amagsty/aDataFlow/README.md

串口查看器。README正在编写中。

[刷机教程（By Justin）](doc/manual/how_to_upload_firmware_BY_Justin.md)
