amagsty/aDataFlow/doc/pcb/BOM/BOM_Board_back_SCH_back_2024-01-13.xlsx

No. | Quantity | Device | Designator | Footprint | Value | Manufacturer Part | Manufacturer | Supplier Part | Supplier | LCSC Stock | LCSC Price
1 | 2 | CL05B104KO5NNNC | C1,C2 | C0402 | 100nF | CL05B104KO5NNNC | SAMSUNG(三星) | C1525 | LCSC | 93587 | 0.007113
2 | 1 | CL10A106KP8NNNC | C3 | C0603 | 10uF | CL10A106KP8NNNC | SAMSUNG(三星) | C19702 | LCSC | 52846 | 0.034305
3 | 36 | 19-213/Y2C-CQ2R2L/3T(CY) | LED1,LED2,LED3,LED4,LED5,LED6,LED7,LED8,LED9,LED10,LED11,LED12,LED13,LED14,LED15,LED16,LED17,LED18,LED19,LED20,LED21,LED22,LED23,LED24,LED25,LED26,LED27,LED28,LED29,LED30,LED31,LED32,LED33,LED34,LED35,LED36 | LED0603-RD-YELLOW |  | 19-213/Y2C-CQ2R2L/3T(CY) | EVERLIGHT(亿光) | C72038 | LCSC | 3903 | 0.129957
4 | 1 | AO3400A_C20917 | Q1 | SOT-23-3_L2.9-W1.6-P1.90-LS2.8-BR |  | AO3400A | AOS | C20917 | LCSC | 19822 | 0.453737
5 | 1 | 0402WGF1002TCE | R1 | R0402 | 10kΩ | 0402WGF1002TCE | UNI-ROYAL(厚声) | C25744 | LCSC | 73640 | 0.003026
6 | 2 | 0402WGF5103TCE | R2,R3 | R0402 | 510kΩ | 0402WGF5103TCE | UNI-ROYAL(厚声) | C11616 | LCSC | 9164 | 0.003056
7 | 9 | 4D03WGJ0102T5E | RN1,RN2,RN3,RN4,RN5,RN6,RN7,RN8,RN9 | RES-ARRAY-SMD_0603-8P-L3.2-W1.6-BL | 1kΩ | 4D03WGJ0102T5E | UNI-ROYAL(厚声) | C20197 | LCSC | 1393 | 0.038673
8 | 2 | 74HC595D,118 | U1,U2 | SOIC-16_L9.9-W3.9-P1.27-LS6.0-BL |  | 74HC595D,118 | Nexperia(安世) | C5947 | LCSC | 14827 | 0.745124
