amagsty/aDataFlow/doc/pcb/BOM/BOM_Board_front_2.51_SCH_front_1_2024-01-13.xlsx

No. | Quantity | Device | Designator | Footprint | Value | Manufacturer Part | Manufacturer | Supplier Part | Supplier | LCSC Stock | LCSC Price
1 | 5 | CL05A475MP5NRNC | C1,C2,C3,C4,C7 | C0402 | 4.7uF | CL05A475MP5NRNC | SAMSUNG(三星) | C23733 | LCSC | 19100 | 0.035571
2 | 3 | CL05B104KO5NNNC | C5,C6,C8 | C0402 | 100nF | CL05B104KO5NNNC | SAMSUNG(三星) | C1525 | LCSC | 93587 | 0.007113
3 | 2 | AFC01-S22FCA-00 | FPC1,FPC2 | FPC-SMD_P0.5-22P_FGS-XJ-H2.0 |  | AFC01-S22FCA-00 | JS(钜硕电子) | C262668 | LCSC | 2495 | 0.723461
4 | 2 | KT-0603R | LED1,LED2 | LED0603-RD |  | KT-0603R | KENTO | C2286 | LCSC | 21883 | 0.034095
5 | 1 | AO3400A_C20917 | Q1 | SOT-23-3_L2.9-W1.6-P1.90-LS2.8-BR |  | AO3400A | AOS | C20917 | LCSC | 19822 | 0.453737
6 | 2 | 0402WGF3300TCE | R1,R2 | R0402 | 330Ω | 0402WGF3300TCE | UNI-ROYAL(厚声) | C25104 | LCSC | 8341 | 0.003481
7 | 4 | 0402WGF1002TCE | R3,R4,R8,R10 | R0402 | 10kΩ | 0402WGF1002TCE | UNI-ROYAL(厚声) | C25744 | LCSC | 73640 | 0.003026
8 | 2 | 0402WGF1001TCE | R5,R6 | R0402 | 1kΩ | 0402WGF1001TCE | UNI-ROYAL(厚声) | C11702 | LCSC | 40589 | 0.003136
9 | 1 | 0603WAF100JT5E | R7 | R0603 | 10Ω | 0603WAF100JT5E | UNI-ROYAL(厚声) | C22859 | LCSC | 28222 | 0.005768
10 | 1 | GT36516 | R9 | RES-SMD_L3.6-W2.4 |  | GT36516 | JCHL(晶创和立) | C2904880 | LCSC | 282 | 1.0097
11 | 2 | TS-1187A-B-A-B | SW1,SW2 | SW-SMD_4P-L5.1-W5.1-P3.70-LS6.5-TL-2 |  | TS-1187A-B-A-B | XKB Connectivity(中国星坤) | C318884 | LCSC | 7282 | 0.09702
12 | 22 | XL-1010RGBC-WS2812B | U1,U2,U3,U4,U5,U6,U7,U8,U9,U10,U11,U12,U13,U14,U15,U16,U17,U18,U19,U20,U21,U22 | LED-SMD_4P-L1.0-W1.0-TL_XL-1010RGBC-WS2812B |  | XL-1010RGBC-WS2812B | XINGLIGHT(成兴光) | C5349953 | LCSC | 1583 | 0.331514
