amagsty/aDataFlow/doc/pcb/BOM/BOM_Board_prog_Schematic1_2024-01-13.xlsx

No. | Quantity | Device | Designator | Footprint | Value | Manufacturer Part | Manufacturer | Supplier Part | Supplier | LCSC Stock | LCSC Price
1 | 5 | YTC1P-2510-01 | CN1,CN2,CN3,CN4,CN5 | SMD-1_BD2.0-H10.0 |  | YTC1P-2510-01 | YIYUAN(怡远) | C5221288 | LCSC | 849 | 0.569205
2 | 1 | PZ254R-11-05P | H1 | HDR-TH_5P-P2.54-H-M-W10.4 |  | PZ254R-11-05P | XFCN(兴飞) | C492413 | LCSC | 57 | 0.19305
