amagsty/aDataFlow/doc/shoppinglist/购买链接.pdf

屏幕

【因屏线尺寸情况，暂无替代屏幕】

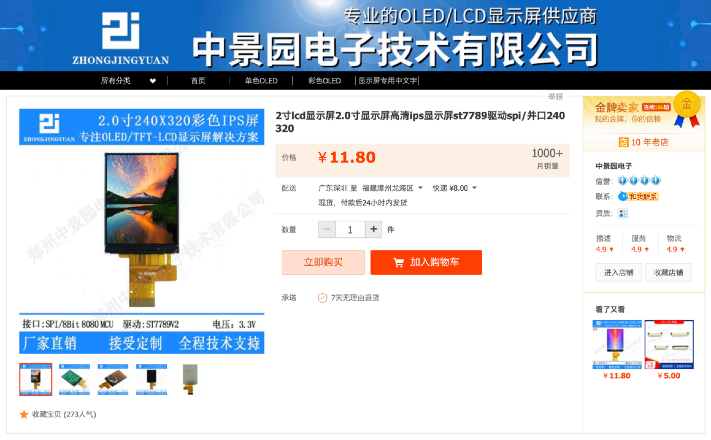
[picture p3: figure]

2寸lcd显示屏2.0寸显示屏高清ips显示屏st7789驱动spi/并口240320 https://item.taobao.com/item.htm?id=653306169973

### 白色铝箔胶带

【关键参数：白色铝箔胶带，厚度0.05左右，宽度1CM左右】

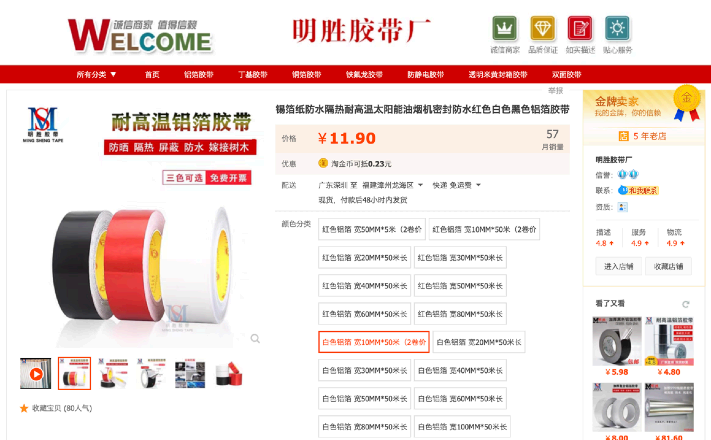
[picture p4: figure]

锡箔纸防水隔热耐高温太阳能油烟机密封防水红色白色黑色铝箔胶带 颜色分类：白色铝箔 宽10MM*50米（2卷价）
https://item.taobao.com/item.htm?id=679579753042

### 螺丝：M2

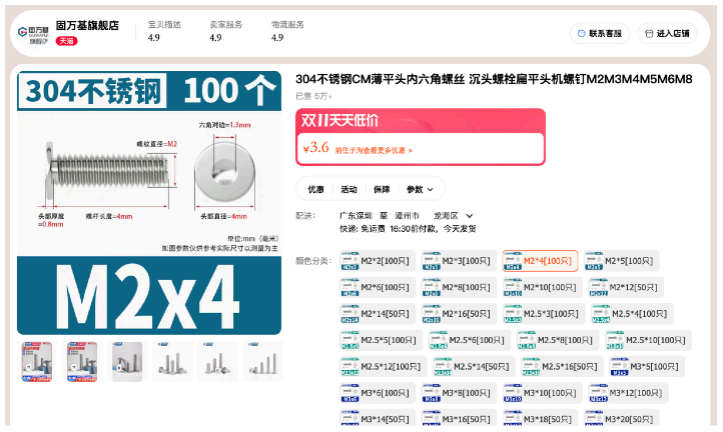
[picture p5: figure]

沉头304不锈钢内六角螺丝
颜色分类：M2*4[100只]
颜色分类：M2*6[100只]
https://item.taobao.com/item.htm?id=643512747051

### 螺丝：M1.6

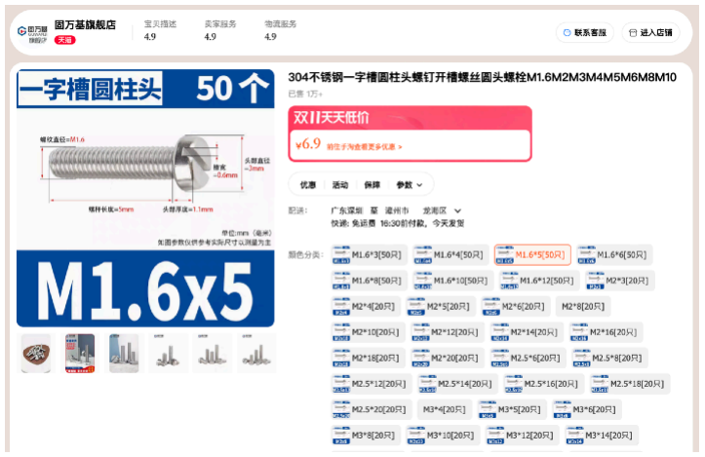
[picture p6: figure]

304不锈钢一字槽圆柱头螺钉开槽螺丝圆头螺栓M1.6M2M3M4M5M6M8M10 颜色分类：M1.6*5[50只]
https://item.taobao.com/item.htm?id=649361914483

### 螺丝弹垫：M2

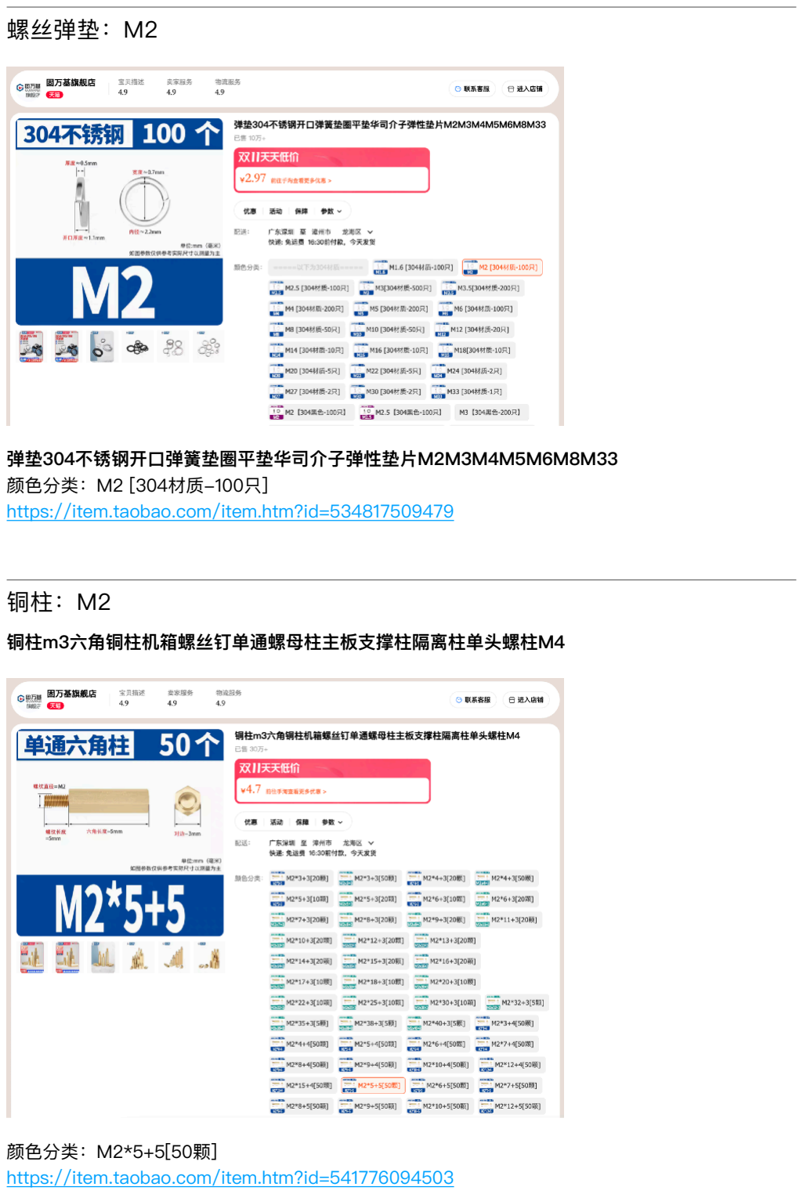
[picture p7: page 3]

弹垫304不锈钢开口弹簧垫圈平垫华司介子弹性垫片M2M3M4M5M6M8M33 颜色分类：M2 [304材质-100只]
https://item.taobao.com/item.htm?id=534817509479

### 铜柱：M2

铜柱m3六角铜柱机箱螺丝钉单通螺母柱主板支撑柱隔离柱单头螺柱M4

颜色分类：M2*5+5[50颗]
https://item.taobao.com/item.htm?id=541776094503

### 亚克力面板弧面抛光块

【关键参数：1000目及1万目】

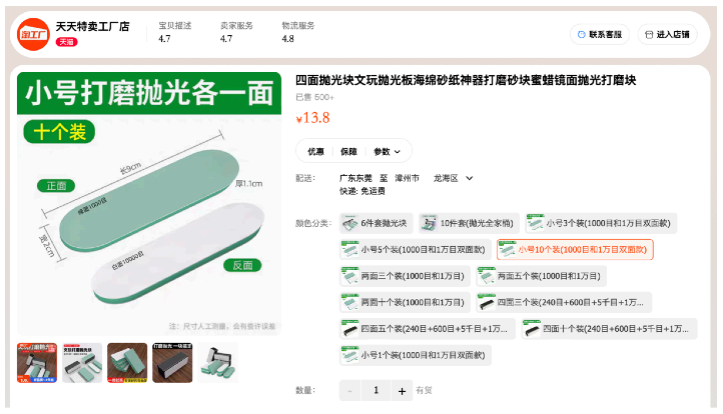
[picture p8: figure]

四面抛光块文玩抛光板海绵砂纸神器打磨砂块蜜蜡镜面抛光打磨块 颜色分类：小号10个装(1000目和1万目双面款)
https://item.taobao.com/item.htm?id=722835001711

脚垫

【关键参数：25MM长，4MM宽】

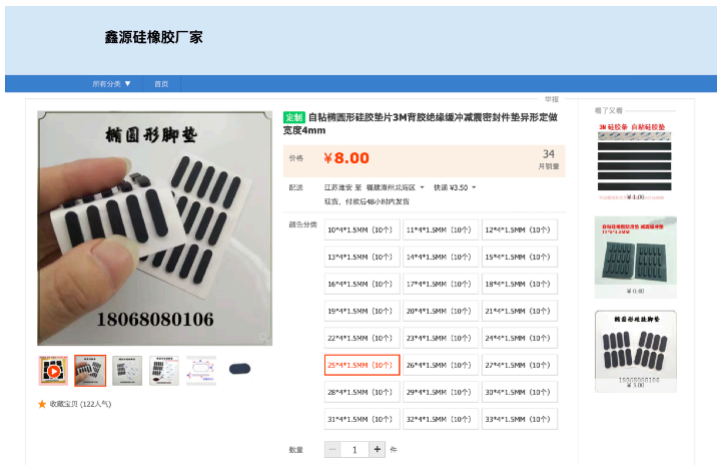
[picture p9: figure]

自粘椭圆形硅胶垫片3M背胶绝缘缓冲减震密封件垫异形定做宽度4mm 颜色分类：25*4*1.5MM（10个）
https://item.taobao.com/item.htm?id=691930664475

### 导光柱

【关键参数：直径1.5MM，长度10MM】

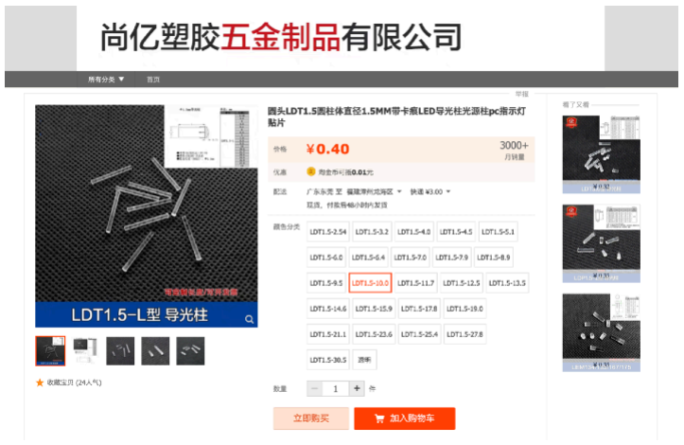
[picture p10: figure]

圆头LDT1.5圆柱体直径1.5MM带卡痕LED导光柱光源柱pc指示灯贴片 颜色分类：LDT1.5-10.0
https://item.taobao.com/item.htm?id=628488136793

电池

【关键参数：452540/502540，厚度≦5MM】

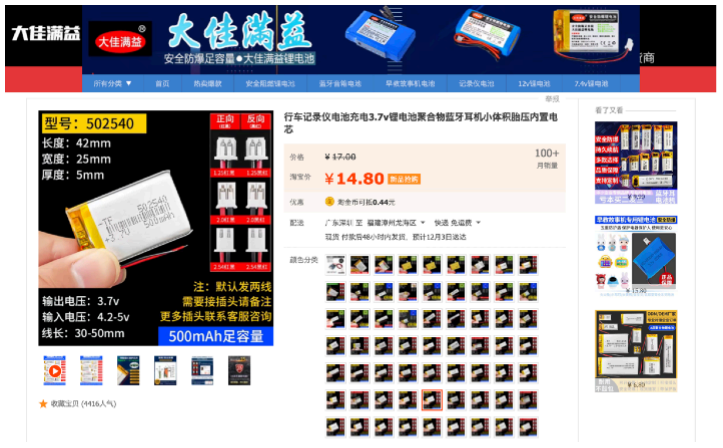
[picture p11: figure]

行车记录仪电池充电3.7v锂电池聚合物蓝牙耳机小体积胎压内置电芯 颜色分类：深卡其布色[502540/500毫安]
https://item.taobao.com/item.htm?id=677735645908
