amagsty/aDataFlow/doc/pcb/BOM/BOM_Board_conn_2.51_SCH_conn_2.51_2024-01-13.xlsx

No. | Quantity | Device | Designator | Footprint | Value | Manufacturer Part | Manufacturer | Supplier Part | Supplier | LCSC Stock | LCSC Price
1 | 2 | PJ-342_C668606 | CN1,CN2 | AUDIO-SMD_PJ-342 |  | PJ-342 | SHOU HAN(首韩) | C668606 | LCSC | 6420 | 1.1074
2 | 1 | X0509FRS-20AS-LPV01 | CN3 | CONN-SMD_20P-P0.50_XKB_X0509FRS-20ADS-LPV01 |  | X0509FRS-20AS-LPV01 | XKB Connectivity(中国星坤) | C2925324 | LCSC | 500 | 3.5
3 | 9 | LESD5D5.0CT1G | D1,D2,D3,D4,D5,D6,D7,D8,D9 | SOD-523_L1.2-W0.8-LS1.6-BI |  | LESD5D5.0CT1G | LRC(乐山无线电) | C383211 | LCSC | 1463 | 0.108493
4 | 1 | 0402WGF1002TCE | R1 | R0402 | 10kΩ | 0402WGF1002TCE | UNI-ROYAL(厚声) | C25744 | LCSC | 73640 | 0.003026
5 | 7 | 0402WGF0000TCE | R2,R3,R5,R7,R8,R9,R10 | R0402 | 0Ω | 0402WGF0000TCE | UNI-ROYAL(厚声) | C17168 | LCSC | 36394 | 0.003049
6 | 2 | 0402WGF5100TCE | R4,R6 | R0402 | 510Ω | 0402WGF5100TCE | UNI-ROYAL(厚声) | C25123 | LCSC | 4102 | 0.003066
7 | 1 | K3-1280S-K1 | SW1 | SW-SMD_K3-1280S-K1 |  | K3-1280S-K1 | 韩国韩荣 | C128953 | LCSC | 101 | 1.0343
8 | 2 | SMTWE2020MTJ | U1,U2 | SMD_BD4.4-L4.4-D2.8 |  | SMTWE2020MTJ | Sinhoo(雄和远景) | C2928177 | LCSC | 536 | 0.358189
