amagsty/aDataFlow/doc/pcb/BOM/BOM_Board_main_2.51_SCH_main_2.51_2024-01-13.xlsx

No. | Quantity | Device | Designator | Footprint | Value | Manufacturer Part | Manufacturer | Supplier Part | Supplier | LCSC Stock | LCSC Price
1 | 3 | CL10A106KP8NNNC | C1,C2,C6 | C0603 | 10uF | CL10A106KP8NNNC | SAMSUNG(三星) | C19702 | LCSC | 52846 | 0.034305
2 | 12 | CL05B104KO5NNNC | C3,C7,C9,C10,C11,C13,C15,C16,C17,C18,C19,C20 | C0402 | 100nF | CL05B104KO5NNNC | SAMSUNG(三星) | C1525 | LCSC | 93587 | 0.007113
3 | 7 | CL05A105KA5NQNC | C4,C5,C14,C28,C29,C30,C31 | C0402 | 1uF | CL05A105KA5NQNC | SAMSUNG(三星) | C52923 | LCSC | 19837 | 0.023666
4 | 5 | CL05A475MP5NRNC | C8,C12,C24,C26,C27 | C0402 | 4.7uF | CL05A475MP5NRNC | SAMSUNG(三星) | C23733 | LCSC | 19100 | 0.035571
5 | 3 | CL21A476MQYNNNE | C21,C22,C23 | C0805 | 47uF | CL21A476MQYNNNE | SAMSUNG(三星) | C16780 | LCSC | 9671 | 0.182771
6 | 1 | 0402CG220J500NT | C25 | C0402 | 22pF | 0402CG220J500NT | FH(风华) | C1555 | LCSC | 3777 | 0.005581
7 | 1 | TF-01A_C91145 | CARD1 | TF-SMD_TF-01A |  | TF-01A | 韩国韩荣 | C91145 | LCSC | 5318 | 1.097
8 | 1 | X0509WVS-20AS-LPV01 | CN1 | CONN-SMD_20P-P0.50_XKB_X0509WVS-20ADS-LPV01 |  | X0509WVS-20AS-LPV01 | XKB Connectivity(中国星坤) | C2925323 | LCSC | 1318 | 3.58
9 | 3 | 1N5819WS_C191023 | D1,D2,D7 | SOD-323_L1.8-W1.3-LS2.5-RD |  | 1N5819WS | Hottech(合科泰) | C191023 | LCSC | 7193 | 0.077033
10 | 3 | LESD5D5.0CT1G | D3,D4,D5 | SOD-523_L1.2-W0.8-LS1.6-BI |  | LESD5D5.0CT1G | LRC(乐山无线电) | C383211 | LCSC | 1463 | 0.108493
11 | 1 | B5819W SL | D6 | SOD-123_L2.7-W1.6-LS3.7-RD-1 |  | B5819W SL | CJ(江苏长电/长晶) | C8598 | LCSC | 18493 | 0.171405
12 | 1 | AFC01-S22FCA-00 | FPC1 | FPC-SMD_P0.5-22P_FGS-XJ-H2.0 |  | AFC01-S22FCA-00 | JS(钜硕电子) | C262668 | LCSC | 2495 | 0.723461
13 | 1 | SWPA3015S100MT | L1 | IND-SMD_L3.0-W3.0_SWPA3010S | 10uH | SWPA3015S100MT | Sunlord(顺络) | C45403 | LCSC | 1293 | 0.250713
14 | 2 | ME6211C33M5G-N | LDO1,LDO2 | SOT-23-5_L3.0-W1.7-P0.95-LS2.8-BL |  | ME6211C33M5G-N | MICRONE(南京微盟) | C82942 | LCSC | 7690 | 0.284668
15 | 1 | KT-0603R | LED1 | LED0603-RD |  | KT-0603R | KENTO | C2286 | LCSC | 21883 | 0.034095
16 | 7 | AO3401A_C15127 | Q1,Q2,Q7,Q8,Q9,Q10,Q11 | SOT-23_L2.9-W1.3-P1.90-LS2.4-BR |  | AO3401A | AOS | C15127 | LCSC | 14112 | 0.394475
17 | 5 | AO3400A_C20917 | Q3,Q4,Q12,Q13,Q14 | SOT-23-3_L2.9-W1.6-P1.90-LS2.8-BR |  | AO3400A | AOS | C20917 | LCSC | 19822 | 0.453737
18 | 2 | SS8050_C2150 | Q5,Q6 | SOT-23-3_L2.9-W1.3-P1.90-LS2.4-BR |  | SS8050 | CJ(江苏长电/长晶) | C2150 | LCSC | 15170 | 0.091187
19 | 13 | 0402WGF1002TCE | R1,R3,R6,R10,R12,R13,R15,R17,R20,R21,R23,R27,R28 | R0402 | 10kΩ | 0402WGF1002TCE | UNI-ROYAL(厚声) | C25744 | LCSC | 73640 | 0.003026
20 | 2 | 0402WGF5100TCE | R2,R5 | R0402 | 510Ω | 0402WGF5100TCE | UNI-ROYAL(厚声) | C25123 | LCSC | 4102 | 0.003066
21 | 3 | 0402WGF1003TCE | R4,R8,R26 | R0402 | 100kΩ | 0402WGF1003TCE | UNI-ROYAL(厚声) | C25741 | LCSC | 27511 | 0.003055
22 | 3 | 0402WGF5101TCE | R7,R14,R16 | R0402 | 5.1kΩ | 0402WGF5101TCE | UNI-ROYAL(厚声) | C25905 | LCSC | 14863 | 0.003109
23 | 2 | 0402WGF1001TCE | R9,R24 | R0402 | 1kΩ | 0402WGF1001TCE | UNI-ROYAL(厚声) | C11702 | LCSC | 40589 | 0.003136
24 | 1 | 0402WGF4702TCE | R11 | R0402 | 47kΩ | 0402WGF4702TCE | UNI-ROYAL(厚声) | C25792 | LCSC | 6289 | 0.003062
25 | 1 | 0402WGF4701TCE | R18 | R0402 | 4.7kΩ | 0402WGF4701TCE | UNI-ROYAL(厚声) | C25900 | LCSC | 64324 | 0.003063
26 | 1 | 0402WGF6801TCE | R19 | R0402 | 6.8kΩ | 0402WGF6801TCE | UNI-ROYAL(厚声) | C25917 | LCSC | 2479 | 0.003046
27 | 1 | 0402WGF3003TCE | R22 | R0402 | 300kΩ | 0402WGF3003TCE | UNI-ROYAL(厚声) | C25774 | LCSC | 4718 | 0.003023
28 | 1 | 0402WGF1501TCE | R25 | R0402 | 1.5kΩ | 0402WGF1501TCE | UNI-ROYAL(厚声) | C25867 | LCSC | 6731 | 0.003338
29 | 2 | 4D02WGJ0103TCE | RN1,RN2 | RES-ARRAY-SMD_0402-8P-L2.0-W1.0-BL | 10kΩ | 4D02WGJ0103TCE | UNI-ROYAL(厚声) | C25725 | LCSC | 20 | 0.028634
30 | 1 | XKB5858-Z-TP-75 | SW1 | SW-SMD_6P-L5.8-W5.8-P2.00-LS8.3 |  | XKB5858-Z-TP-75 | XKB Connectivity(中国星坤) | C692487 | LCSC | 289 | 1.4605
31 | 1 | ESP32-S3-WROOM-1U-N4R2 | U1 | WIRELM-SMD_ESP32-S3-WROOM-1U |  | ESP32-S3-WROOM-1U-N4R2 | ESPRESSIF(乐鑫) | C3013942 | LCSC | 359 | 25.01
32 | 1 | TP4054-42-SOT25R | U2 | SOT-23-5_L3.0-W1.7-P0.95-LS2.8-BL |  | TP4054-42-SOT25R | TOPPOWER(南京拓微) | C32574 | LCSC | 1452 | 0.824451
33 | 1 | LM393DR2G | U3 | SOIC-8_L5.0-W4.0-P1.27-LS6.0-BL |  | LM393DR2G | onsemi(安森美) | C7955 | LCSC | 2291 | 1.4339
34 | 2 | SIQ-02FVS3 | U4,U6 | SW-SMD_SIQ-02FVS3_1 |  | SIQ-02FVS3 | MITSUMI(美上美) | C2925423 | LCSC | 215 | 14.31
35 | 1 | CP2102-GMR | U5 | WQFN-28_L5.0-W5.0-P0.50-BL-EP3.2 |  | CP2102-GMR | SILICON LABS(芯科) | C6568 | LCSC | 4525 | 12.7
36 | 1 | TXS0102DCUR | U7 | VSON8_L2.0-W2.3-P0.50-LS3.1-BL |  | TXS0102DCUR | TI(德州仪器) | C53434 | LCSC | 4664 | 2.0481
37 | 4 | YTC1P-4020-01 | U8,U9,U10,U12 | TESTPOINT-SMD_BD2.0_YTC1P-4020-01 |  | YTC1P-4020-01 | YIYUAN(怡远) | C5221284 | LCSC | 629 | 0.6237
38 | 1 | TPS61040DBVR | U11 | SOT-23-5_L3.0-W1.7-P0.95-LS2.8-BL |  | TPS61040DBVR | TI(德州仪器) | C7722 | LCSC | 3901 | 1.2767
39 | 1 | GT-USB-7051A | USB1 | USB-C-SMD_GT-USB-7051A |  | GT-USB-7051A | G-Switch(品赞) | C2843970 | LCSC | 5212 | 2.61
