amagsty/aDataFlow/doc/stl/base_3dp_v2.7.STL

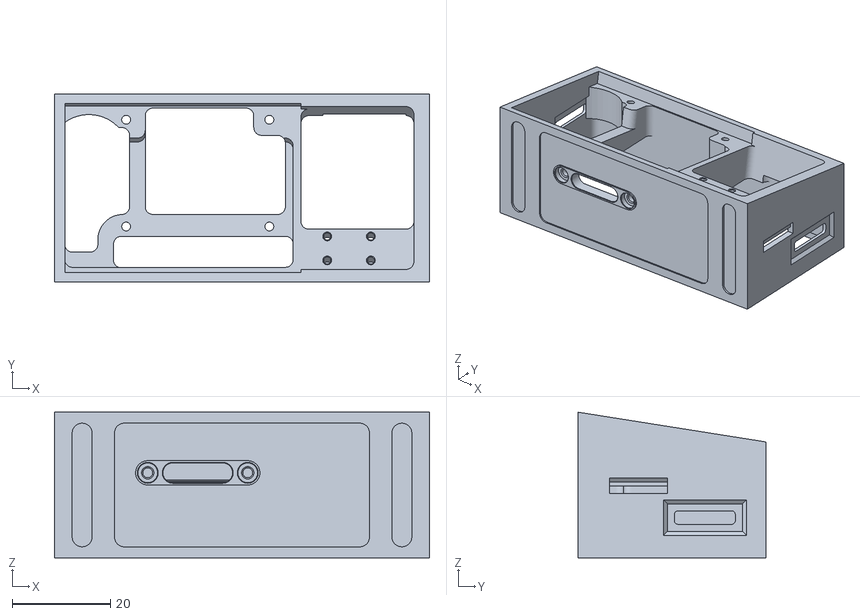
[picture p12: CAD file, 2024-01-13]
doc/stl/base_3dp_v2.7.STL
76.2 x 38.1 x 29.6
