amagsty/aDataFlow/doc/stl/dupont_4pin_shell.STL

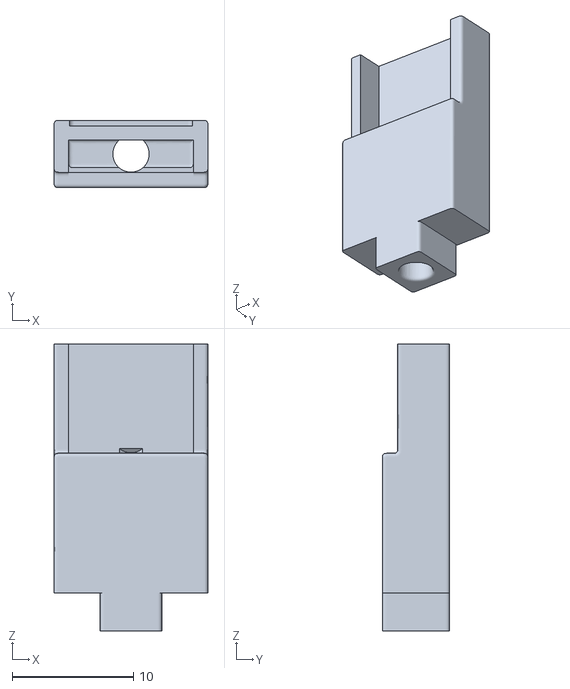
[picture p13: CAD file, 2024-01-13]
doc/stl/dupont_4pin_shell.STL
12.7 x 5.56 x 23.7
