amagsty/aDataFlow/doc/stl/button_group_v2.71.STL

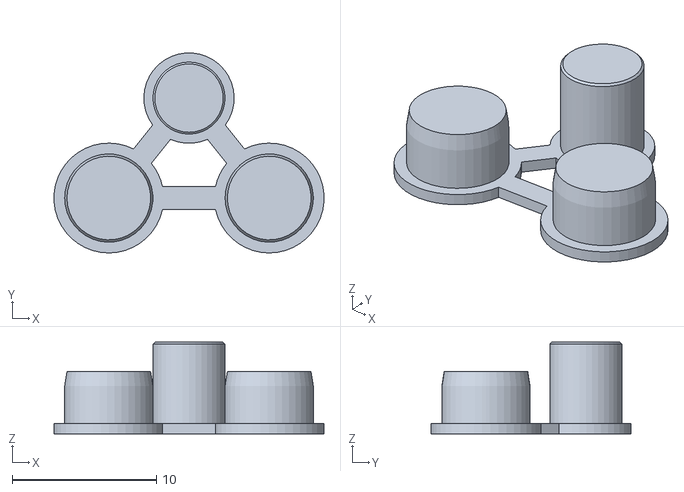
[picture p14: CAD file, 2024-01-13]
doc/stl/button_group_v2.71.STL
18.7 x 13.9 x 6.35
