amagsty/aDataFlow/CHANGELOG.md

# 更新日志

## 1.2.1 (2024.02.07)

### 变更

- 提升串口在高波特率下的读写性能

### 新增

- 添加发行版BIN，可使用 flash_download_tool 等工具直接烧录

## 1.2.0 (2024.02.05)

### 变更

- 串口数据读取方式重写以提升速度及稳定性
- 当前行与历史行颜色统一为同一色值
- SD卡变更为直接录制原始数据

## 1.1.0 (2024.01.13)

### 修复

- 电量显示错误（检测引脚加入input pullup初始化）
- 因未加入serial.timeout而触发watchdog重启的问题
- 图表模式解析json可能误判类型而引起溢出重启的问题

### 新增

- 加入ADC内部校准
- 配合新PCB的背光亮度，更改PWM阈值
- 关机时记住当前的波特率，下次开机时直接使用
- 文字模式时，不需要按下就可以滚动滚轮查看上方log
- ArduinoJSON库升级至 7.0.0
- 字库字型扩展到了ASCII extended （0x20-0xff）
- 图表模式时，按下左侧按钮可 zoom in图表至最大Y范围

## 1.0.0 (2023.12.12)
### 新增

- 初始版本发布
