amagsty/aDataFlow/doc/pcb/SCH_SCH_front_1_2024-01-13.pdf

# RGB

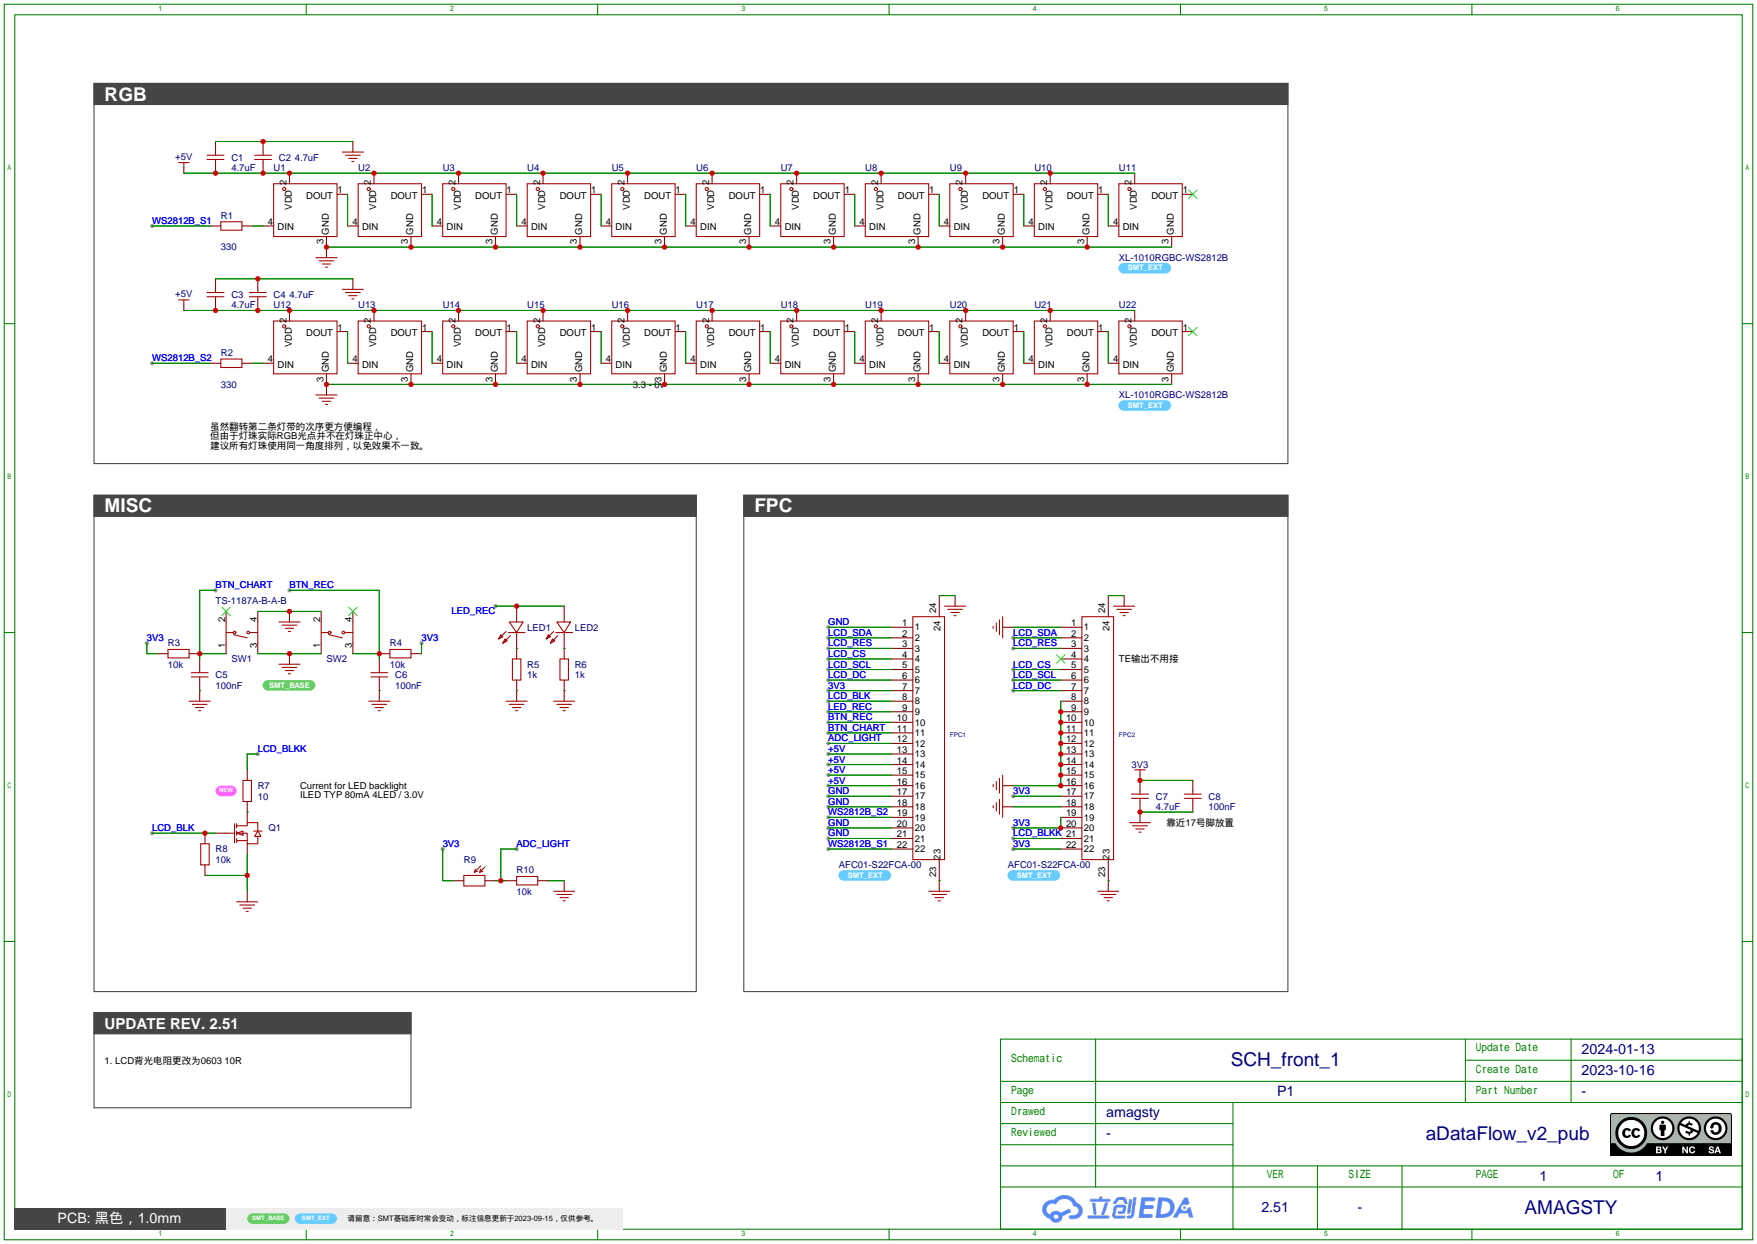
[picture p80: page 1]

Current for LED backlight
ILED TYP 80mA 4LED / 3.0V
