amagsty/aDataFlow/doc/pcb/SCH_SCH_main_2.51_2024-01-13.pdf

IO12 20 IO13 21 IO14 22 IO21 23 IO47 24 IO48 25 IO45 26 IO0 27 IO35 28 IO36 29 IO37 30 IO38 31 IO39 32 IO40 33 IO41 34 IO42 35 RXD0 36 TXD0 37 IO2 38 IO1 39 GND 40 GND 41

## ESP32_S3

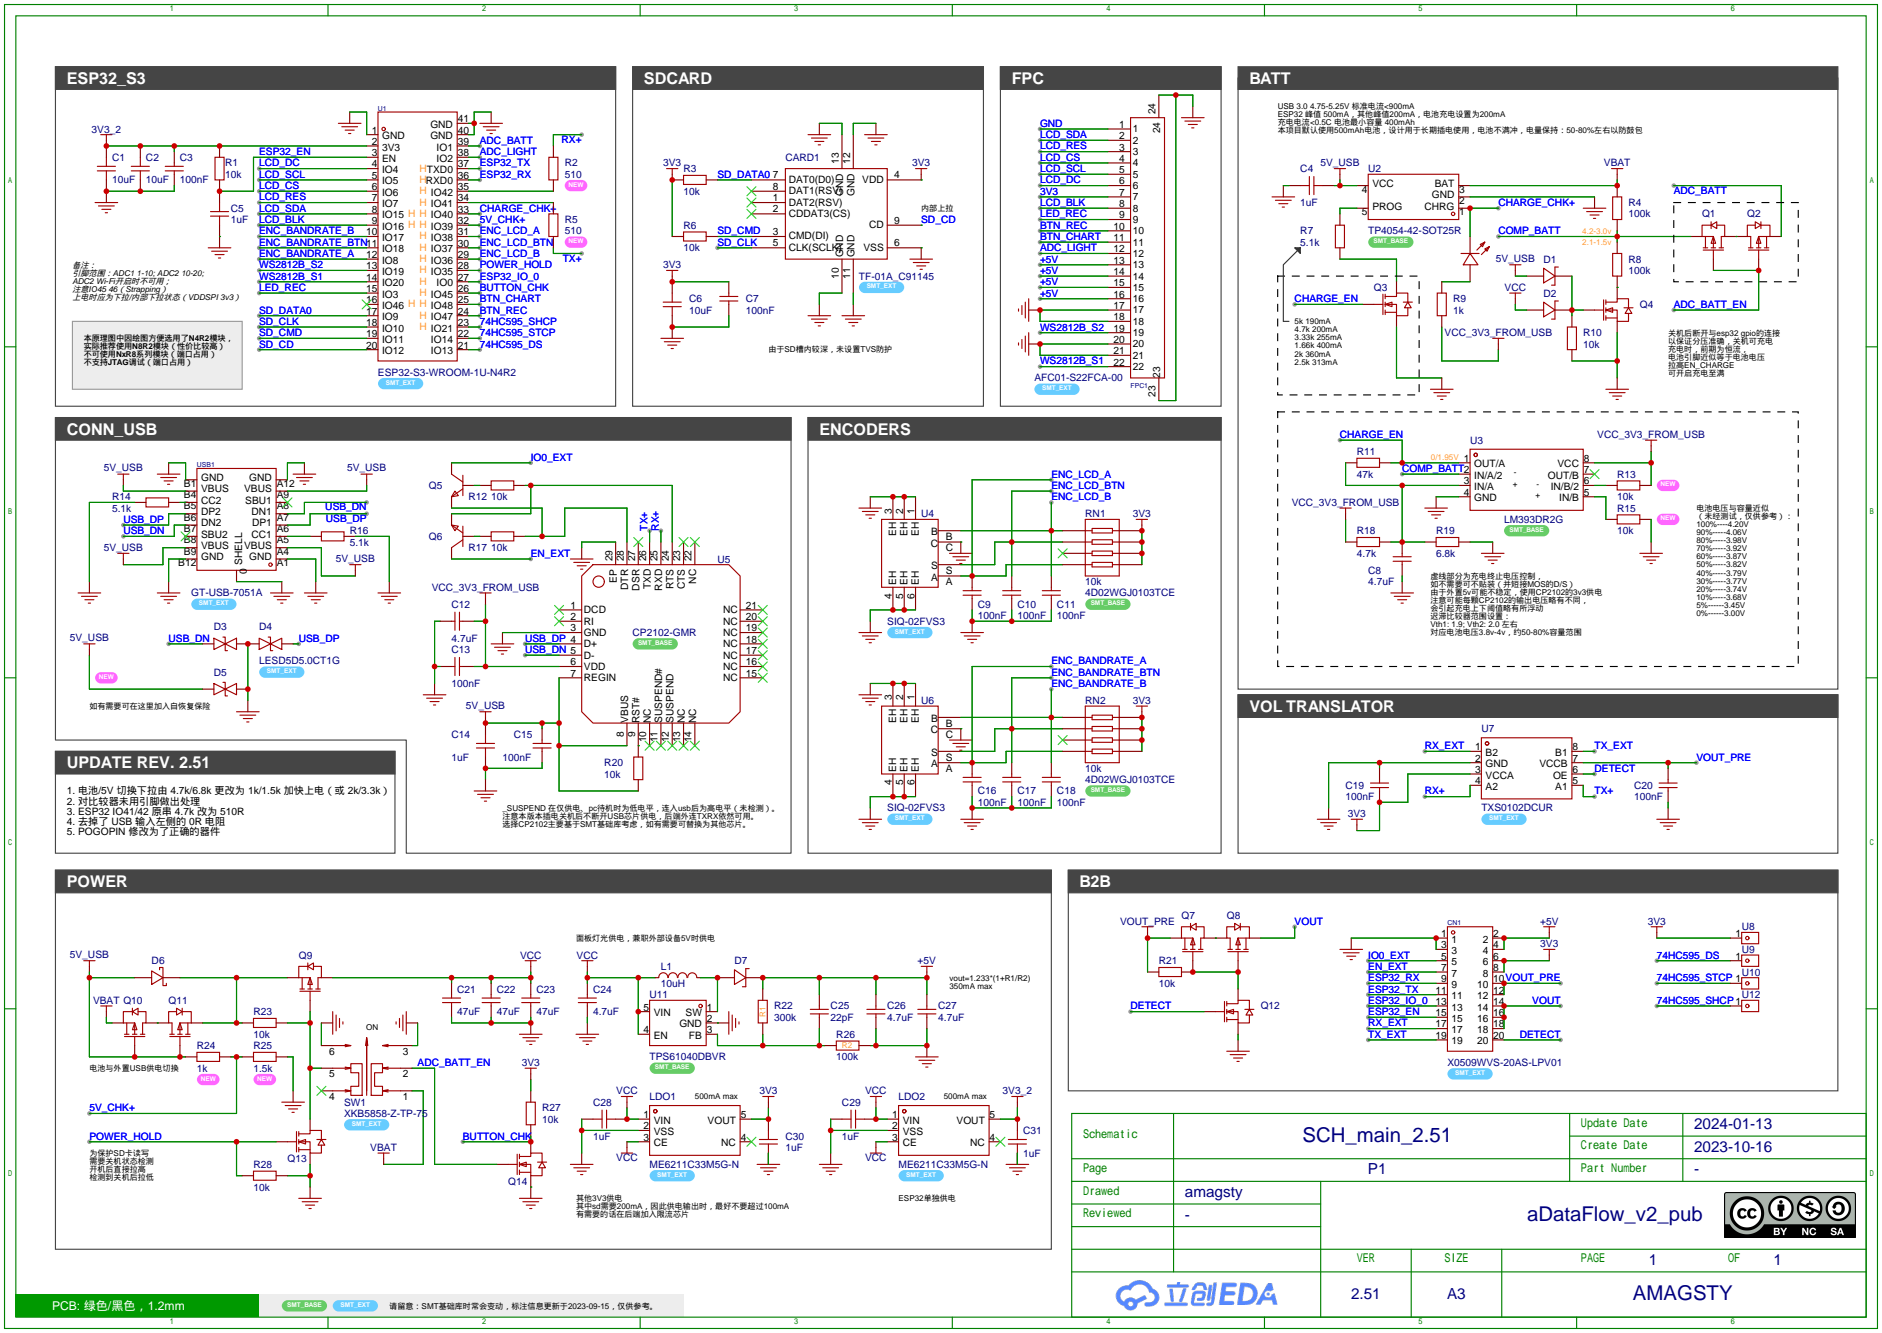
[picture p81: page 1]

USB 3.0 4.75-5.25V 标准电流<900mA
ESP32 峰值 500mA，其他峰值200mA，电池充电设置为200mA
充电电流<0.5C 电池最小容量 400mAh
本项目默认使用500mAh电池，设计用于长期插电使用，电池不满冲，电量保持：50-80%左右以防鼓包

NC 22 CTS 23 RTS 24 RXD 25 TXD 26 DSR 27 DTR 28 EP 29

1. 电池/5V 切换下拉由 4.7k/6.8k 更改为 1k/1.5k 加快上电（或 2k/3.3k）
2. 对比较器未用引脚做出处理
3. ESP32 IO41/42 原串 4.7k 改为 510R
4. 去掉了 USB 输入左侧的 0R 电阻
5. POGOPIN 修改为了正确的器件

_SUSPEND 在仅供电、pc待机时为低电平，连入usb后为高电平（未检测）。
注意本版本插电关机后不断开USB芯片供电，后端外连TXRX依然可用。
选择CP2102主要基于SMT基础库考虑，如有需要可替换为其他芯片。
