amagsty/aDataFlow/doc/pcb/SCH_SCH_back_2024-01-13.pdf

INDICATORS | BACKLIGHT

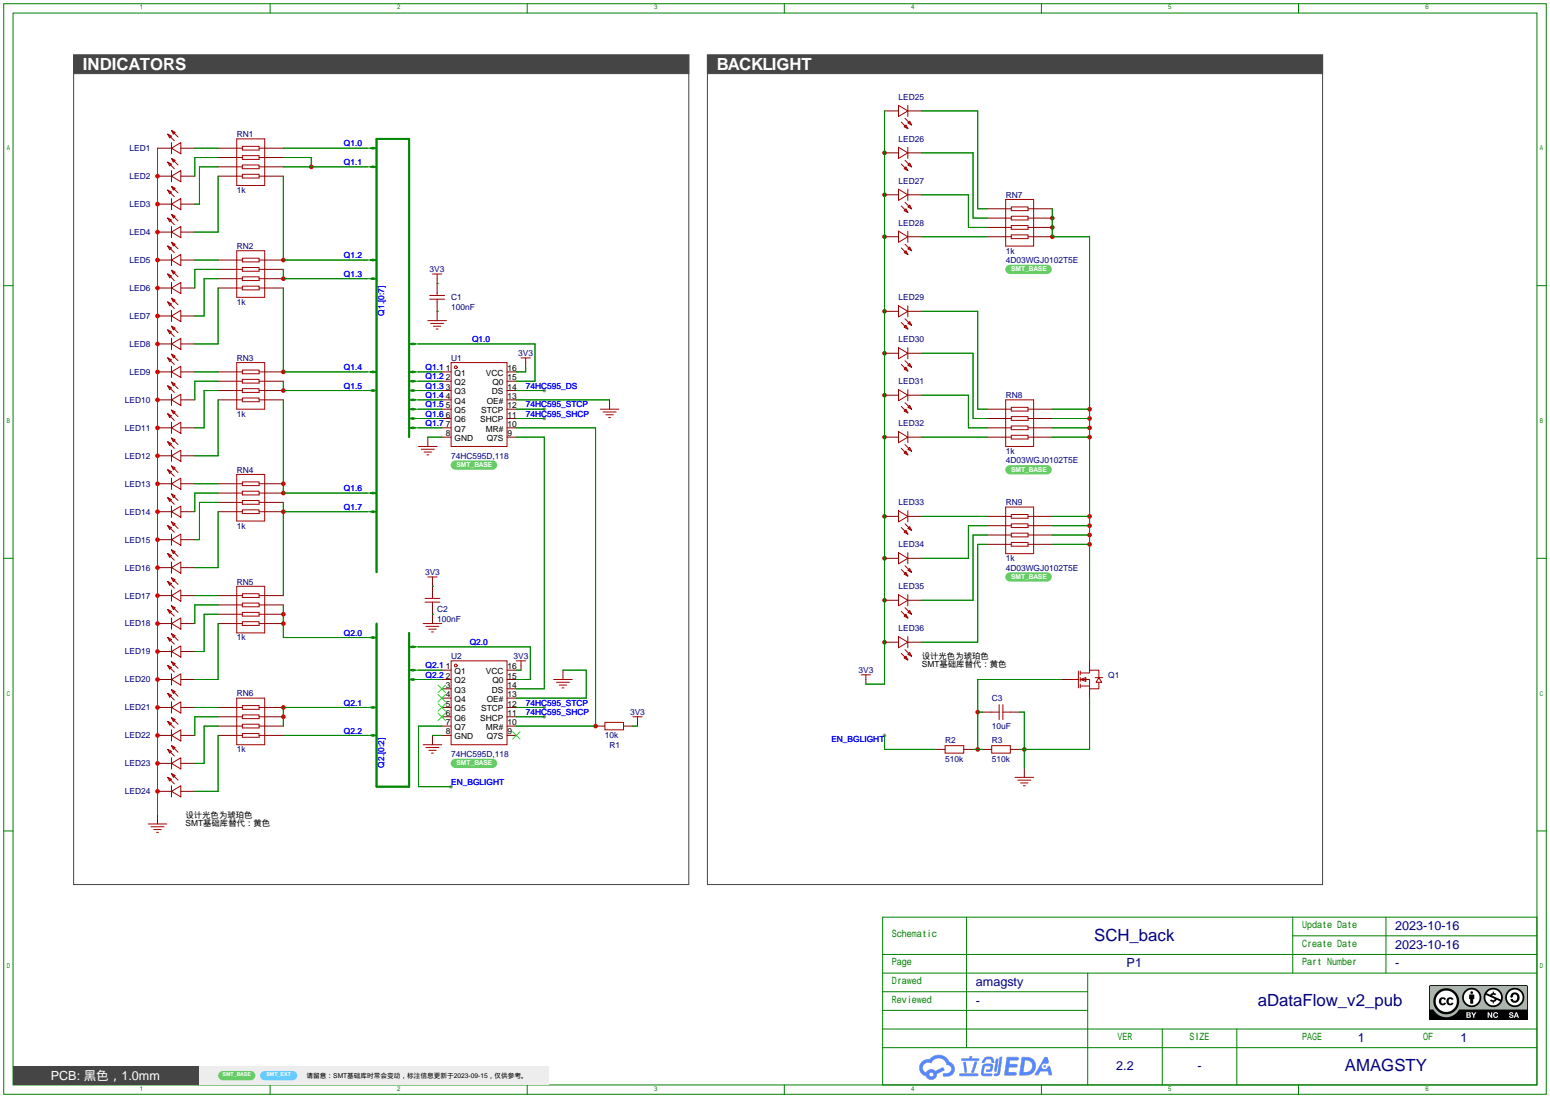
[picture p82: page 1]

MR# 10 SHCP 11 STCP 12 OE# 13 DS 14 Q0 15 VCC 16
