amagsty/aDataFlow/doc/pcb/SCH_SCH_conn_2.51_2024-01-13.pdf

CONN_EXT | TVS

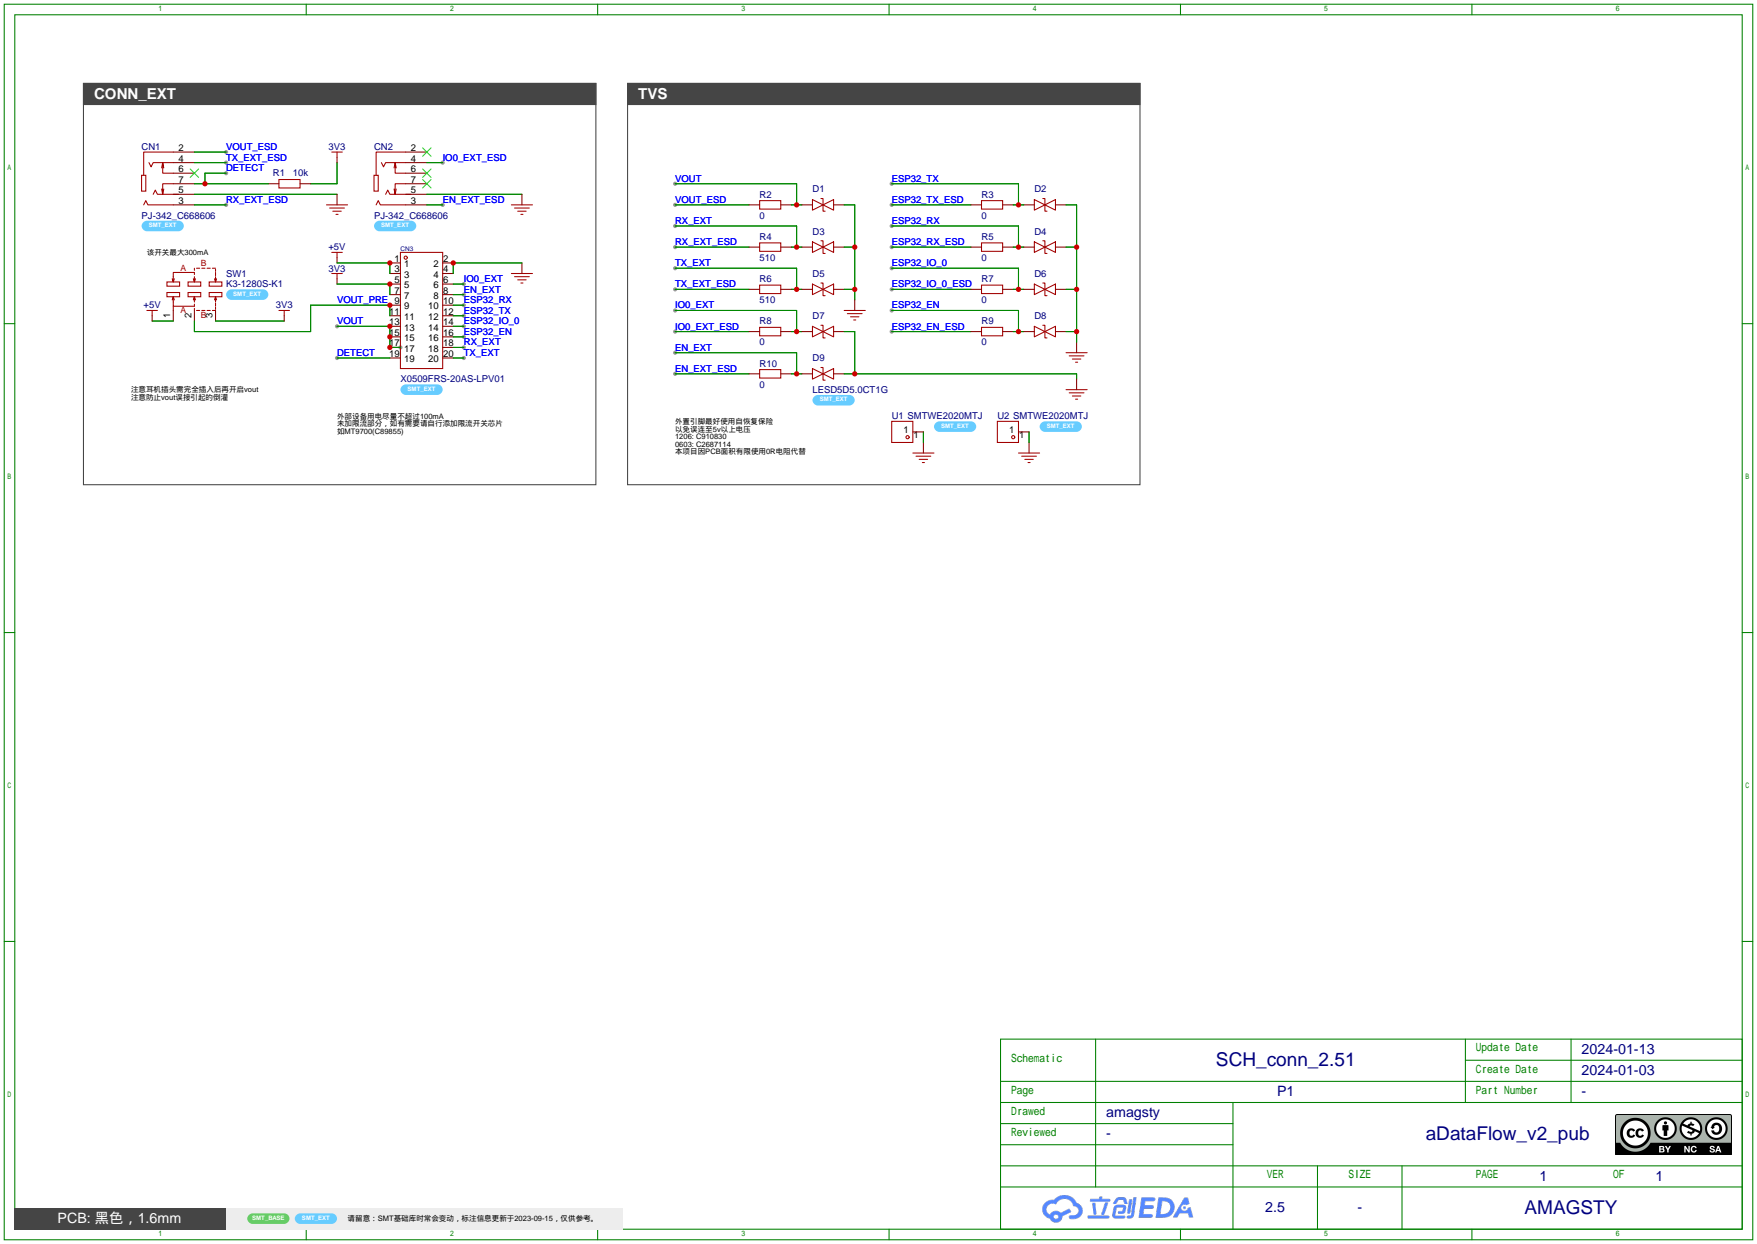
[picture p83: page 1]
