amagsty/aDataFlow/(list of files, drawings)

Other design files:
doc/pcb/ProProject_aDataFlow_v2_pub_2024-01-13.epro
