amagsty/aDataFlow/include/pins.h

#ifndef _PINS_H
#define _PINS_H

#define PIN_LCD_DC 4
#define PIN_LCD_SCL 5
#define PIN_LCD_CS 6
#define PIN_LCD_RES 7
#define PIN_LCD_SDA 15
#define PIN_LCD_BLK 16

#define PIN_ENC_BANDRATE_B 17
#define PIN_ENC_BANDRATE_BTN 18
#define PIN_ENC_BANDRATE_A 8

#define PIN_WS2812B_S1 20
#define PIN_WS2812B_S2 19

#define PIN_SD_DATA0 9
#define PIN_SD_CLK  10
#define PIN_SD_CMD 11
#define PIN_SD_CD 12

#define PIN_ADC_BATT 1
#define PIN_ADC_LIGHT 2

#define PIN_RX 42
#define PIN_TX 41

#define PIN_CHARGE_CHK 40
#define PIN_5V_CHK 39
#define PIN_POWER_HOLD 35
#define PIN_BUTTON_CHK 45

#define PIN_ENC_LCD_A 38
#define PIN_ENC_LCD_BTN 37
#define PIN_ENC_LCD_B 36

#define PIN_BTN_CHART 48
#define PIN_BTN_REC 47
#define PIN_LED_REC 3

#define PIN_74HC595_SHCP 21
#define PIN_74HC595_STCP 14
#define PIN_74HC595_DS 13



#endif
