amagsty/aDataFlow/include/main.h

#ifndef _MAIN_H
#define _MAIN_H

#define PROJECT_NANE "aDataFlow"
#define FIRMWARE_VERSION "1.2.1"
#define HARDWARE_VERSION_PCB_MAIN ">=2.5"
#define HARDWARE_VERSION_PCB_FRONT ">=2.3"
#define HARDWARE_VERSION_PCB_CONN ">=2.4"
#define HARDWARE_VERSION_PCB_BACK ">=2.2"

extern bool test_mode;

#endif
