amagsty/aDataFlow/(commit log)

2024-01-13 更新changelog
2024-01-13 添加3D、面板、PCB工程等文件
    [BOM_Board_back_SCH_back_2024-01-13.xlsx, BOM_Board_conn_2.51_SCH_conn_2.51_2024-01-13.xlsx, BOM_Board_front_2.51_SCH_front_1_2024-01-13.xlsx, BOM_Board_main_2.51_SCH_main_2.51_2024-01-13.xlsx, BOM_Board_prog_Schematic1_2024-01-13.xlsx, ProProject_aDataFlow_v2_pub_2024-01-13.epro, base_3dp_v2.7.STL, button_group_v2.71.STL]
2024-01-17 add Assembly-Guide.pdf
2024-01-23 记录输出调试信息由log_i更改为log_d
2024-01-23 测试新套件文档版面
2024-01-23 测试版面
2024-01-24 临时手册
2024-01-24 更新组装参考手册
2024-01-24 临时readme
2024-01-24 更新组装手册
2024-01-27 修改背光PWM频率，避免发出声音
2024-01-27 修改开机画面
2024-02-06 变更SD记录方式为直接记录原数据
2024-02-06 更改队列模式；当前行历史行统一颜色
2024-02-06 重写串口读取，由轮询改为回调
2024-02-06 修改部分变量
2024-02-06 1.2.0 更新内容
2024-02-06 提高在高波特率下的读取性能
2024-02-06 变更版本号
2024-02-08 添加刷机教程（By Justin）
2024-02-08 添加刷新教程_by_Justin
2024-02-08 修改刷机教程路径名
2024-02-08 修改刷机教程路径
